NoPantsNoLife/RM_Campus_Main_Controller/README.md

# RM_Campus_Main_Controller

## 翻车电控

电机信号要加隔离！！！电机信号要加隔离！！！电机信号要加隔离！！！电机信号要加隔离！！！电机信号要加隔离！！！

单片机烧的很爽

H743的项目是最初在开发板上搭的，H750的项目是做出PCB之后的

因为板子烧没了，程序没有完全调好

基本的遥控接收 麦轮解算 测速 PID 循迹传感器读取都在

除了PID的参数可能还有问题，基本都能用

缺循迹程序 机械臂程序
