NoPantsNoLife/RM_Campus_Main_Controller/Hardware/MainController.xlsx

Comment | Description | Designator | Footprint | LibRef | Quantity
0.1uF |  | C1, C4, C5, C6, C7, C8, C9, C19, C20, C37, C47, C48 | 0402 | Cap | 12
10uF |  | C2, C3, C11, C12, C13, C14, C15, C16, C17, C18, C21, C22, C28, C31, C32, C39, C40 | 0805 | Cap | 17
1uF |  | C23 | 0603 | Cap | 1
2.2uF |  | C24 | 0603 | Cap | 1
2.2uF |  | C25, C26 | 0402 | Cap | 2
3.3nF |  | C27 | 0402 | Cap | 1
0.1uF |  | C29 | 0805 | Cap | 1
1nF |  | C30 | 0402 | Cap | 1
10pF |  | C33, C34 | 0402 | Cap | 2
6.8nF |  | C35 | 0402 | Cap | 1
150pF |  | C36 | 0402 | Cap | 1
0.1uF |  | C38, C41 | 0603 | Cap | 2
22uF |  | C43, C44, C45 | 0603 | Cap | 3
10uF |  | C49, C50, C51, C52 | 0603 | Cap | 4
LED |  | D1, D2, D3, D4, D5 | 0603LED | LED | 5
XH_7P |  | J1, J2, J6, J7 | XH_7P直插立式 | XH_7P | 4
XH_10P |  | J3, J4, J8, J9 | XH_10P直插立式 | XH_10P | 4
SMA |  | J5 | SMA_Edge | Coax | 1
XH_5P |  | J10, J11, J12, J13, J15, J16 | XH_5P直插立式 | XH_5P | 6
2.54_1x3P |  | J14 | 2.54排针_1x3立式 | 2.54_1x3P | 1
2.54_1x6P |  | J17 | 2.54排针_1x6立式 | 2.54_1x6P | 1
XT60PW-M |  | J18, J19 | XT60PW-M20 | XT60PW-M | 2
2.54_1x7P |  | J20, J21 | 2.54排针_1x7立式 | 2.54_1x7P | 2
1uH | Inductor | L1 | IND-SMD_L11.5-W10.5_1004 | Inductor | 1
1.5uH | Inductor | L2 | IND-SMD_L7.1-W6.6_0630 | Inductor | 1
RFM69H |  | M1 | RFM69H | RFM69H | 1
CSD17577Q5A |  | Q1, Q2 | SON-8_L5.0-W6.0-P1.27-BL_MOSFET | MOS_N_SON8 | 2
10k | Resistor | R1, R2, R3, R4, R5, R8, R13, R15 | 0402 | Res | 8
0 | Resistor | R6, R9 | 0402 | Res | 2
237 | Resistor | R7 | 0402 | Res | 1
887 | Resistor | R10 | 0402 | Res | 1
7.15k | Resistor | R11 | 0402 | Res | 1
1.54k | Resistor | R12 | 0402 | Res | 1
45.3k | Resistor | R14 | 0402 | Res | 1
1k | Resistor | R16, R17, R18, R19, R20 | 0402 | Res | 5
Button |  | SW1, SW2, SW3 | KEY-SMD_4P-L6.0-W6.0-P4.50-LS8.6 | Button | 3
STM32H750VBT6 |  | U1 | LQFP-100_L14.0-W14.0-P0.50-LS16.0-BL | STM32H750VBT6 | 1
TPS40305DRCR |  | U2 | VSON-10_L3.0-W3.0-P0.50-TL-EP | TPS40305DRCR | 1
W25Q64JVSSIQ |  | U3 | SOP-8_L5.3-W5.3-P1.27-LS8.0-BL | W25Q64JVSSIQ | 1
TPS563240 |  | U4 | SOT-23-6_L2.9-W1.6-P0.95-LS2.8-BR | TPS563240 | 1
8MHz |  | X1 | OSC-SMD_4P-L3.2-W2.5-BL | Crystal_4P | 1
