NoPantsNoLife/RM_Campus_Main_Controller/(list of files, cad)

Other CAD files:
Hardware/电控外形.DWG
