NoPantsNoLife/RM_Campus_Main_Controller/Hardware/MainController.PDF

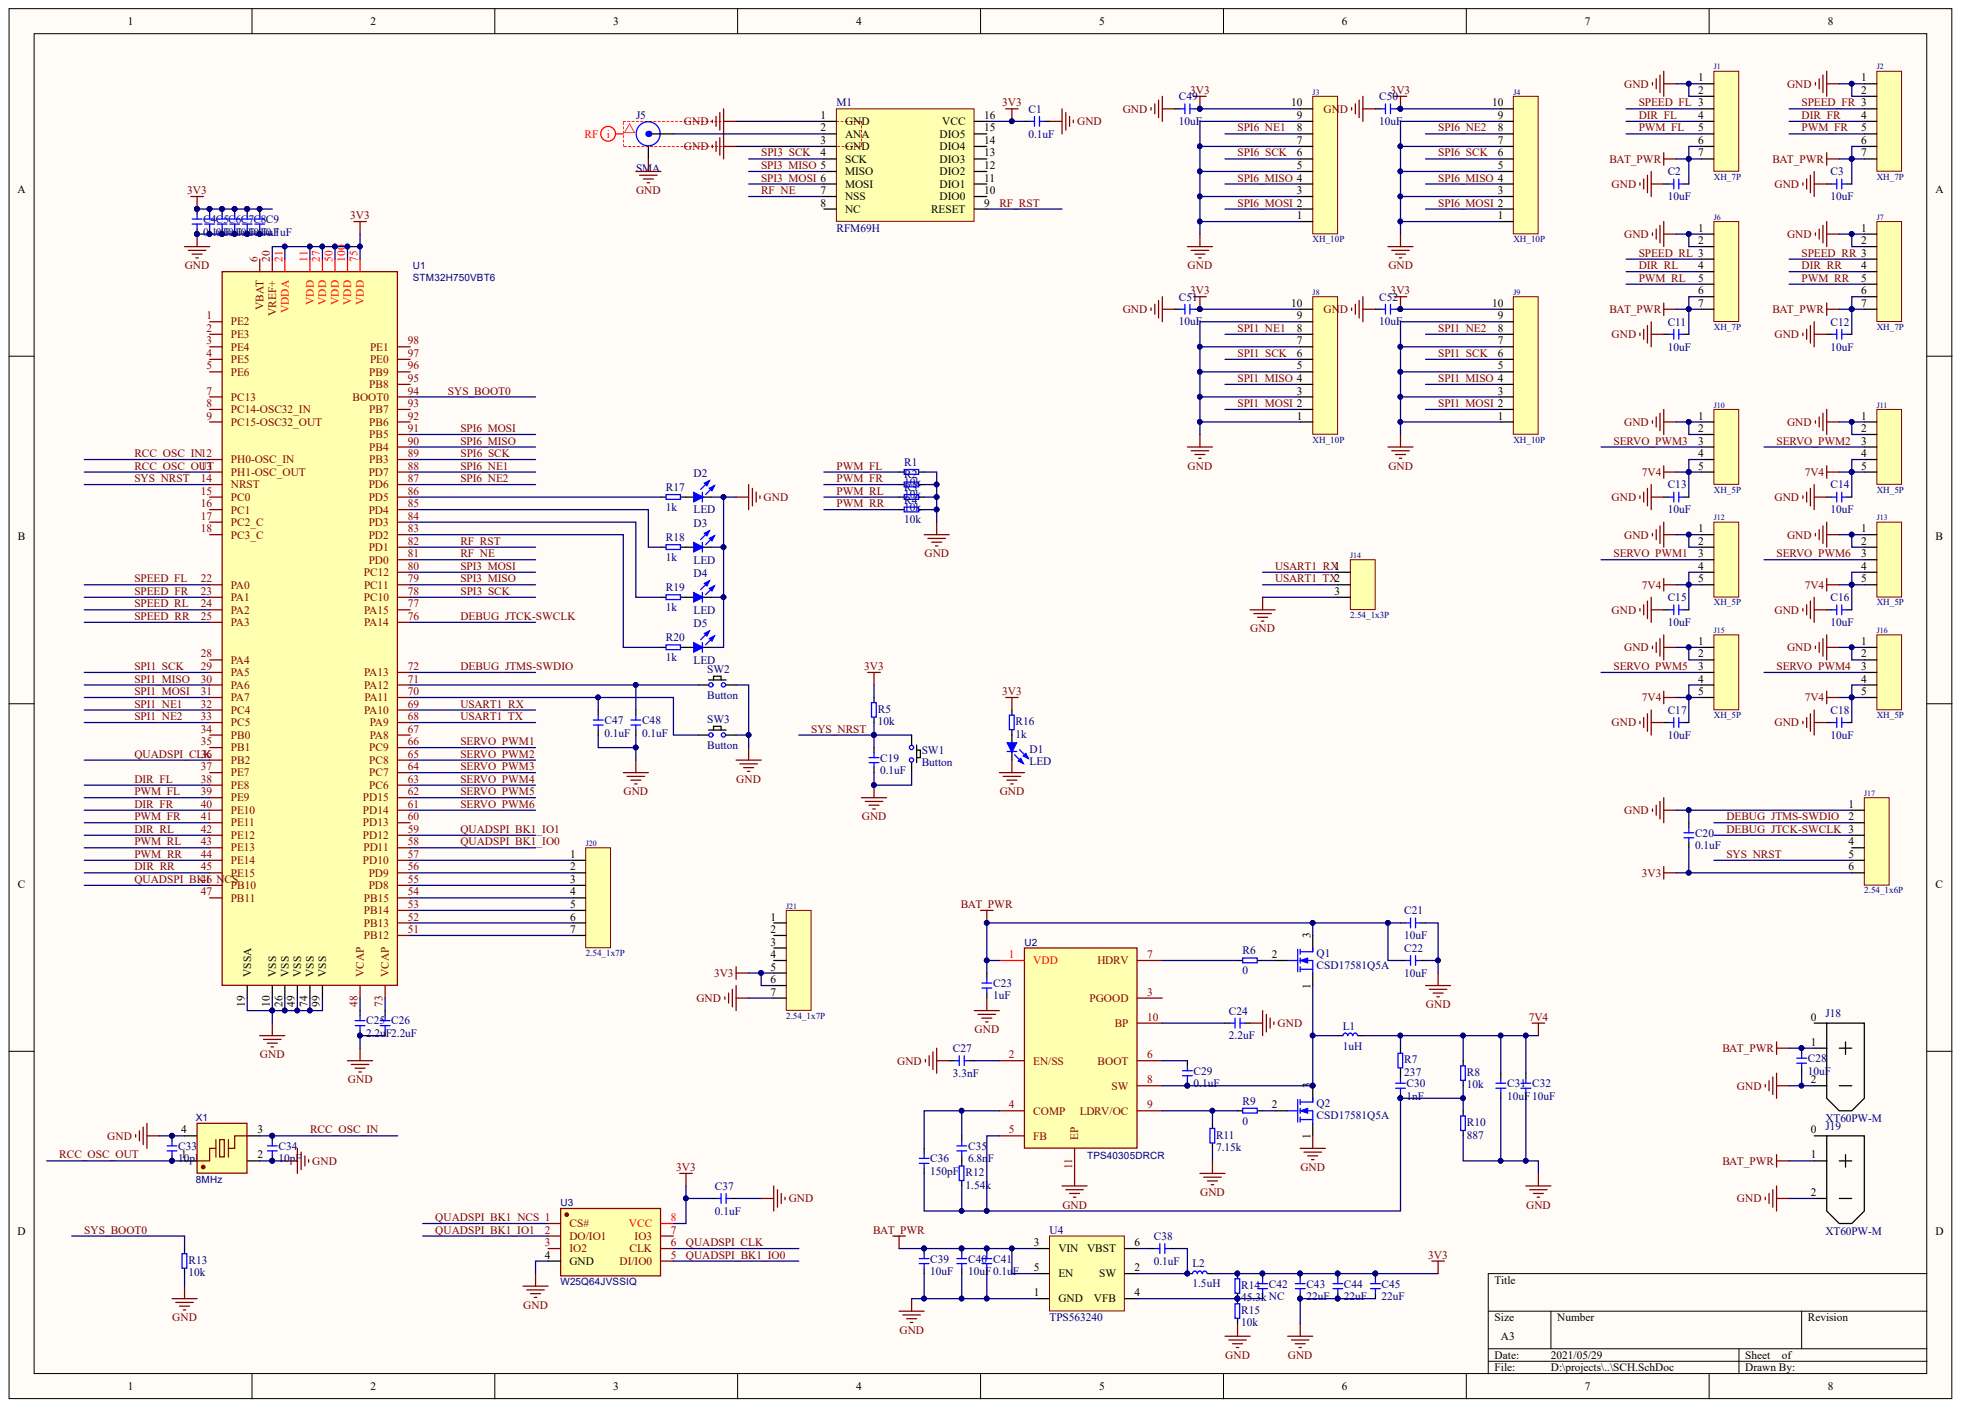
[picture p1: page 1]

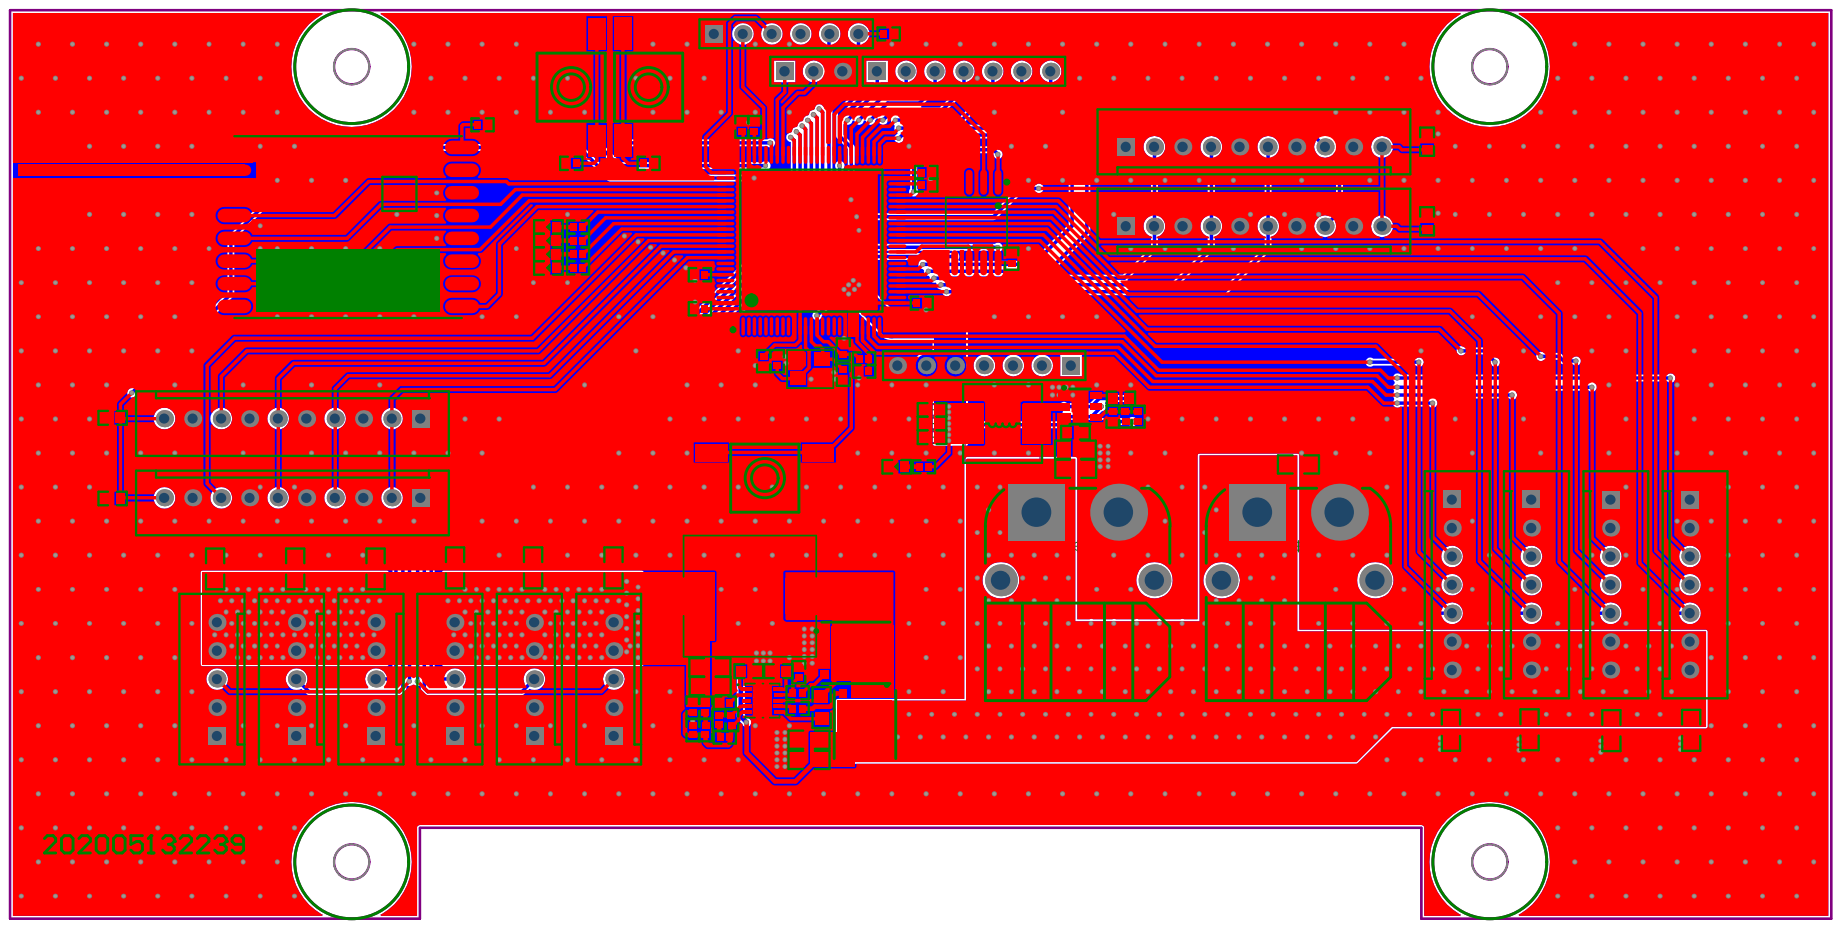
[picture p2: page 2]
