NoPantsNoLife/RM_Campus_Main_Controller/(list of files, drawings)

Other design files:
Hardware/MainController.PrjPcb
Hardware/PCB.PcbDoc
Hardware/SCH.SchDoc
