NoPantsNoLife/RM_Campus_Main_Controller/MCU_FW/h750_motor_pid_pwm_ads7953/h750_motor_pid_pwm_ads7953.ioc

Mcu.UserName=STM32H743VITx
PA0.GPIO_Label=SPEED_FL
PA0.Signal=S_TIM2_CH1
PA1.GPIO_Label=SPEED_FR
PA1.Signal=S_TIM2_CH2
PA10.Signal=USART1_RX
PA2.GPIO_Label=SPEED_RL
PA2.Signal=S_TIM2_CH3
PA3.GPIO_Label=SPEED_RR
PA3.Signal=S_TIM2_CH4
PA5.Signal=SPI1_SCK
PA6.Signal=SPI1_MISO
PA7.Signal=SPI1_MOSI
PA9.Signal=USART1_TX
PB10.Signal=QUADSPI_BK1_NCS
PB12.GPIO_Label=DIR_FL
PB12.Signal=GPIO_Output
PB2.Signal=QUADSPI_CLK
PB5.Signal=SPI6_MOSI
PC10.Signal=SPI3_SCK
PC11.Signal=SPI3_MISO
PC12.Signal=SPI3_MOSI
PC4.GPIO_Label=SPI1_NE1
PC4.Signal=GPIO_Output
PC5.GPIO_Label=SPI1_NE2
PC5.Signal=GPIO_Output
PC6.GPIO_Label=SERVO_PWM4
PC6.Signal=S_TIM3_CH1
PC7.GPIO_Label=SERVO_PWM3
PC7.Signal=S_TIM3_CH2
PC8.GPIO_Label=SERVO_PWM2
PC8.Signal=S_TIM3_CH3
PC9.GPIO_Label=SERVO_PWM1
PC9.Signal=S_TIM3_CH4
PD0.GPIO_Label=RF_NE
PD0.Signal=GPIO_Output
PD1.GPIO_Label=RF_RST
PD1.Signal=GPIO_Output
PD11.Signal=QUADSPI_BK1_IO0
PD12.Signal=QUADSPI_BK1_IO1
PD14.GPIO_Label=SERVO_PWM6
PD14.Signal=S_TIM4_CH3
PD15.GPIO_Label=SERVO_PWM5
PD15.Signal=S_TIM4_CH4
PD2.GPIO_Label=LED1
PD2.Signal=GPIO_Output
PD3.GPIO_Label=LED2
PD3.Signal=GPIO_Output
PD4.GPIO_Label=LED3
PD4.Signal=GPIO_Output
PD5.GPIO_Label=LED4
PD5.Signal=GPIO_Output
PD6.GPIO_Label=SPI6_NE2
PD6.Signal=GPIO_Output
PD7.GPIO_Label=SPI6_NE1
PD7.Signal=GPIO_Output
PE10.GPIO_Label=DIR_FR
PE10.Signal=GPIO_Output
PE11.GPIO_Label=PWM_FR
PE11.Signal=S_TIM1_CH2
PE12.GPIO_Label=DIR_RL
PE12.Signal=GPIO_Output
PE13.GPIO_Label=PWM_RL
PE13.Signal=S_TIM1_CH3
PE14.GPIO_Label=PWM_RR
PE14.Signal=S_TIM1_CH4
PE15.GPIO_Label=DIR_RR
PE15.Signal=GPIO_Output
PE9.GPIO_Label=PWM_FL
PE9.Signal=S_TIM1_CH1
