NoPantsNoLife/RM_Campus_Main_Controller/MCU_FW/h750_motor_pid_pwm_ads7953/Core/Inc/main.h

#define SPEED_FL_Pin LL_GPIO_PIN_0
#define SPEED_FL_GPIO_Port GPIOA
#define SPEED_FR_Pin LL_GPIO_PIN_1
#define SPEED_FR_GPIO_Port GPIOA
#define SPEED_RL_Pin LL_GPIO_PIN_2
#define SPEED_RL_GPIO_Port GPIOA
#define SPEED_RR_Pin LL_GPIO_PIN_3
#define SPEED_RR_GPIO_Port GPIOA
#define SPI1_NE1_Pin LL_GPIO_PIN_4
#define SPI1_NE1_GPIO_Port GPIOC
#define SPI1_NE2_Pin LL_GPIO_PIN_5
#define SPI1_NE2_GPIO_Port GPIOC
#define PWM_FL_Pin LL_GPIO_PIN_9
#define PWM_FL_GPIO_Port GPIOE
#define DIR_FR_Pin LL_GPIO_PIN_10
#define DIR_FR_GPIO_Port GPIOE
#define PWM_FR_Pin LL_GPIO_PIN_11
#define PWM_FR_GPIO_Port GPIOE
#define DIR_RL_Pin LL_GPIO_PIN_12
#define DIR_RL_GPIO_Port GPIOE
#define PWM_RL_Pin LL_GPIO_PIN_13
#define PWM_RL_GPIO_Port GPIOE
#define PWM_RR_Pin LL_GPIO_PIN_14
#define PWM_RR_GPIO_Port GPIOE
#define DIR_RR_Pin LL_GPIO_PIN_15
#define DIR_RR_GPIO_Port GPIOE
#define DIR_FL_Pin LL_GPIO_PIN_12
#define DIR_FL_GPIO_Port GPIOB
#define SERVO_PWM6_Pin LL_GPIO_PIN_14
#define SERVO_PWM6_GPIO_Port GPIOD
#define SERVO_PWM5_Pin LL_GPIO_PIN_15
#define SERVO_PWM5_GPIO_Port GPIOD
#define SERVO_PWM4_Pin LL_GPIO_PIN_6
#define SERVO_PWM4_GPIO_Port GPIOC
#define SERVO_PWM3_Pin LL_GPIO_PIN_7
#define SERVO_PWM3_GPIO_Port GPIOC
#define SERVO_PWM2_Pin LL_GPIO_PIN_8
#define SERVO_PWM2_GPIO_Port GPIOC
#define SERVO_PWM1_Pin LL_GPIO_PIN_9
#define SERVO_PWM1_GPIO_Port GPIOC
#define RF_NE_Pin LL_GPIO_PIN_0
#define RF_NE_GPIO_Port GPIOD
#define RF_RST_Pin LL_GPIO_PIN_1
#define RF_RST_GPIO_Port GPIOD
#define LED1_Pin LL_GPIO_PIN_2
#define LED1_GPIO_Port GPIOD
#define LED2_Pin LL_GPIO_PIN_3
#define LED2_GPIO_Port GPIOD
#define LED3_Pin LL_GPIO_PIN_4
#define LED3_GPIO_Port GPIOD
#define LED4_Pin LL_GPIO_PIN_5
#define LED4_GPIO_Port GPIOD
#define SPI6_NE2_Pin LL_GPIO_PIN_6
#define SPI6_NE2_GPIO_Port GPIOD
#define SPI6_NE1_Pin LL_GPIO_PIN_7
#define SPI6_NE1_GPIO_Port GPIOD
#define NVIC_PRIORITYGROUP_0         ((uint32_t)0x00000007) /*!< 0 bit  for pre-emption priority,
#define NVIC_PRIORITYGROUP_1         ((uint32_t)0x00000006) /*!< 1 bit  for pre-emption priority,
#define NVIC_PRIORITYGROUP_2         ((uint32_t)0x00000005) /*!< 2 bits for pre-emption priority,
#define NVIC_PRIORITYGROUP_3         ((uint32_t)0x00000004) /*!< 3 bits for pre-emption priority,
#define NVIC_PRIORITYGROUP_4         ((uint32_t)0x00000003) /*!< 4 bits for pre-emption priority,
