NoPantsNoLife/RM_Campus_Main_Controller/MCU_FW/h743-pwm-motor/Core/Src/spi.c

/**
  ******************************************************************************
  * @file    spi.c
  * @brief   This file provides code for the configuration
  *          of the SPI instances.
  ******************************************************************************
  * @attention
  *
  * <h2><center>&copy; Copyright (c) 2021 STMicroelectronics.
  * All rights reserved.</center></h2>
  *
  * This software component is licensed by ST under BSD 3-Clause license,
  * the "License"; You may not use this file except in compliance with the
  * License. You may obtain a copy of the License at:
  *                        opensource.org/licenses/BSD-3-Clause
  *
  ******************************************************************************
  */

/* Includes ------------------------------------------------------------------*/
#include "spi.h"

/* SPI1 init function */
void MX_SPI1_Init(void)
{
  LL_SPI_InitTypeDef SPI_InitStruct = {0};

  LL_GPIO_InitTypeDef GPIO_InitStruct = {0};

  /* Peripheral clock enable */
  LL_APB2_GRP1_EnableClock(LL_APB2_GRP1_PERIPH_SPI1);

  LL_AHB4_GRP1_EnableClock(LL_AHB4_GRP1_PERIPH_GPIOA);
  /**SPI1 GPIO Configuration
  PA5   ------> SPI1_SCK
  PA6   ------> SPI1_MISO
  PA7   ------> SPI1_MOSI
  */
  GPIO_InitStruct.Pin = LL_GPIO_PIN_5|LL_GPIO_PIN_6|LL_GPIO_PIN_7;
  GPIO_InitStruct.Mode = LL_GPIO_MODE_ALTERNATE;
  GPIO_InitStruct.Speed = LL_GPIO_SPEED_FREQ_LOW;
  GPIO_InitStruct.OutputType = LL_GPIO_OUTPUT_PUSHPULL;
  GPIO_InitStruct.Pull = LL_GPIO_PULL_NO;
  GPIO_InitStruct.Alternate = LL_GPIO_AF_5;
  LL_GPIO_Init(GPIOA, &GPIO_InitStruct);

  SPI_InitStruct.TransferDirection = LL_SPI_FULL_DUPLEX;
  SPI_InitStruct.Mode = LL_SPI_MODE_MASTER;
  SPI_InitStruct.DataWidth = LL_SPI_DATAWIDTH_8BIT;
  SPI_InitStruct.ClockPolarity = LL_SPI_POLARITY_LOW;
  SPI_InitStruct.ClockPhase = LL_SPI_PHASE_1EDGE;
  SPI_InitStruct.NSS = LL_SPI_NSS_SOFT;
  SPI_InitStruct.BaudRate = LL_SPI_BAUDRATEPRESCALER_DIV64;
  SPI_InitStruct.BitOrder = LL_SPI_MSB_FIRST;
  SPI_InitStruct.CRCCalculation = LL_SPI_CRCCALCULATION_DISABLE;
  SPI_InitStruct.CRCPoly = 0x0;
  LL_SPI_Init(SPI1, &SPI_InitStruct);
  LL_SPI_SetStandard(SPI1, LL_SPI_PROTOCOL_MOTOROLA);
  LL_SPI_EnableNSSPulseMgt(SPI1);

}
/* SPI3 init function */
void MX_SPI3_Init(void)
{
  LL_SPI_InitTypeDef SPI_InitStruct = {0};

  LL_GPIO_InitTypeDef GPIO_InitStruct = {0};

  /* Peripheral clock enable */
  LL_APB1_GRP1_EnableClock(LL_APB1_GRP1_PERIPH_SPI3);

  LL_AHB4_GRP1_EnableClock(LL_AHB4_GRP1_PERIPH_GPIOC);
  /**SPI3 GPIO Configuration
  PC10   ------> SPI3_SCK
  PC11   ------> SPI3_MISO
  PC12   ------> SPI3_MOSI
  */
  GPIO_InitStruct.Pin = LL_GPIO_PIN_10|LL_GPIO_PIN_11|LL_GPIO_PIN_12;
  GPIO_InitStruct.Mode = LL_GPIO_MODE_ALTERNATE;
  GPIO_InitStruct.Speed = LL_GPIO_SPEED_FREQ_LOW;
  GPIO_InitStruct.OutputType = LL_GPIO_OUTPUT_PUSHPULL;
  GPIO_InitStruct.Pull = LL_GPIO_PULL_NO;
  GPIO_InitStruct.Alternate = LL_GPIO_AF_6;
  LL_GPIO_Init(GPIOC, &GPIO_InitStruct);

  SPI_InitStruct.TransferDirection = LL_SPI_FULL_DUPLEX;
  SPI_InitStruct.Mode = LL_SPI_MODE_MASTER;
  SPI_InitStruct.DataWidth = LL_SPI_DATAWIDTH_8BIT;
  SPI_InitStruct.ClockPolarity = LL_SPI_POLARITY_LOW;
  SPI_InitStruct.ClockPhase = LL_SPI_PHASE_1EDGE;
  SPI_InitStruct.NSS = LL_SPI_NSS_SOFT;
  SPI_InitStruct.BaudRate = LL_SPI_BAUDRATEPRESCALER_DIV64;
  SPI_InitStruct.BitOrder = LL_SPI_MSB_FIRST;
  SPI_InitStruct.CRCCalculation = LL_SPI_CRCCALCULATION_DISABLE;
  SPI_InitStruct.CRCPoly = 0x0;
  LL_SPI_Init(SPI3, &SPI_InitStruct);
  LL_SPI_SetStandard(SPI3, LL_SPI_PROTOCOL_MOTOROLA);
  LL_SPI_EnableNSSPulseMgt(SPI3);

}
/* SPI4 init function */
void MX_SPI4_Init(void)
{
  LL_SPI_InitTypeDef SPI_InitStruct = {0};

  LL_GPIO_InitTypeDef GPIO_InitStruct = {0};

  /* Peripheral clock enable */
  LL_APB2_GRP1_EnableClock(LL_APB2_GRP1_PERIPH_SPI4);

  LL_AHB4_GRP1_EnableClock(LL_AHB4_GRP1_PERIPH_GPIOE);
  /**SPI4 GPIO Configuration
  PE2   ------> SPI4_SCK
  PE5   ------> SPI4_MISO
  PE6   ------> SPI4_MOSI
  */
  GPIO_InitStruct.Pin = LL_GPIO_PIN_2|LL_GPIO_PIN_5|LL_GPIO_PIN_6;
  GPIO_InitStruct.Mode = LL_GPIO_MODE_ALTERNATE;
  GPIO_InitStruct.Speed = LL_GPIO_SPEED_FREQ_LOW;
  GPIO_InitStruct.OutputType = LL_GPIO_OUTPUT_PUSHPULL;
  GPIO_InitStruct.Pull = LL_GPIO_PULL_NO;
  GPIO_InitStruct.Alternate = LL_GPIO_AF_5;
  LL_GPIO_Init(GPIOE, &GPIO_InitStruct);

  SPI_InitStruct.TransferDirection = LL_SPI_FULL_DUPLEX;
  SPI_InitStruct.Mode = LL_SPI_MODE_MASTER;
  SPI_InitStruct.DataWidth = LL_SPI_DATAWIDTH_8BIT;
  SPI_InitStruct.ClockPolarity = LL_SPI_POLARITY_LOW;
  SPI_InitStruct.ClockPhase = LL_SPI_PHASE_1EDGE;
  SPI_InitStruct.NSS = LL_SPI_NSS_SOFT;
  SPI_InitStruct.BaudRate = LL_SPI_BAUDRATEPRESCALER_DIV16;
  SPI_InitStruct.BitOrder = LL_SPI_MSB_FIRST;
  SPI_InitStruct.CRCCalculation = LL_SPI_CRCCALCULATION_DISABLE;
  SPI_InitStruct.CRCPoly = 0x0;
  LL_SPI_Init(SPI4, &SPI_InitStruct);
  LL_SPI_SetStandard(SPI4, LL_SPI_PROTOCOL_MOTOROLA);
  LL_SPI_EnableNSSPulseMgt(SPI4);

}

/* USER CODE BEGIN 1 */
uint8_t SPI_ReadWriteByte(SPI_TypeDef *SPIx, uint8_t TxData)
{
	uint8_t resv_buff = 0;
	LL_SPI_StartMasterTransfer(SPIx);
	while (LL_SPI_IsActiveFlag_TXP(SPIx) == 0);
	LL_SPI_TransmitData8(SPIx, TxData);
	while (LL_SPI_IsActiveFlag_RXP(SPIx) == 0);
	resv_buff = LL_SPI_ReceiveData8(SPIx);
	//LL_SPI_ClearFlag_TXTF(SPIx);
	//LL_SPI_ClearFlag_EOT(SPIx);
	//LL_SPI_SuspendMasterTransfer(SPIx);
	return resv_buff;
}

/* USER CODE END 1 */

/************************ (C) COPYRIGHT STMicroelectronics *****END OF FILE****/
